thebrakshow/VORON/PCB/XY Endstop/README.md

XY Endstop

# MZBOT XY Endstop
Hall effect endstop board for X and Y axes

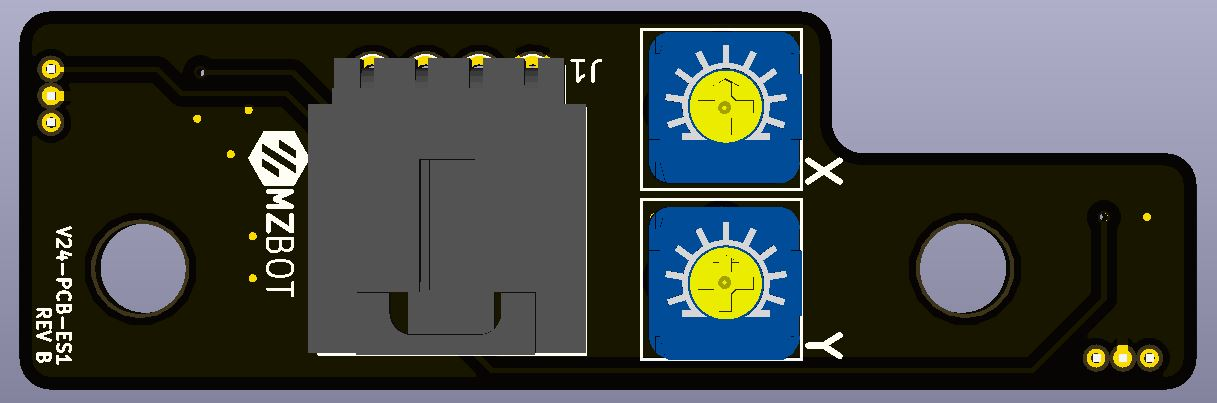
[picture p1: PCB/XY Endstop/XY_Endstop_Top.JPG]

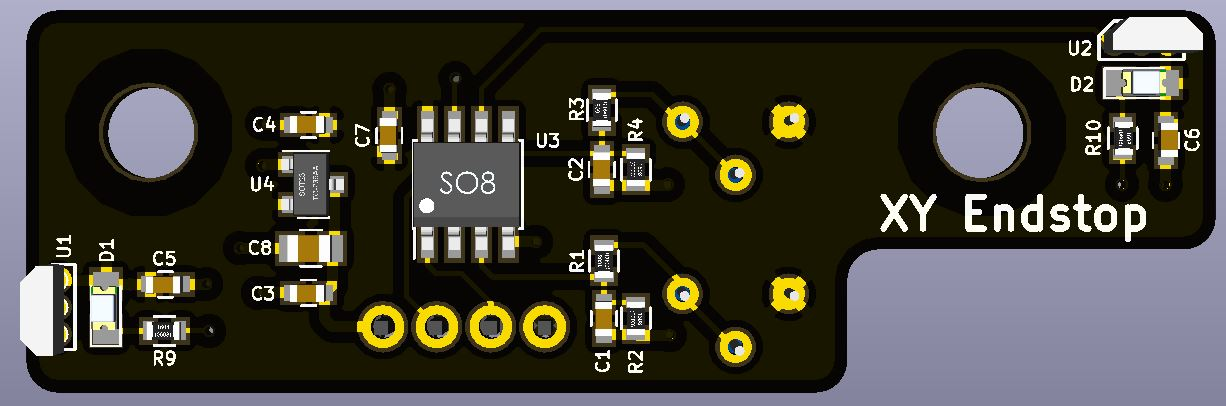
[picture p2: PCB/XY Endstop/XY_Endstop_Back.JPG]
