thebrakshow/VORON/PCB/RAMPS Expansion/README.md

# VORON V2-Expander
Expansion PCB to add 3 additional stepper drivers, 2 external PWM fans, and induction probe port to a standard RAMPS 1.4 shield

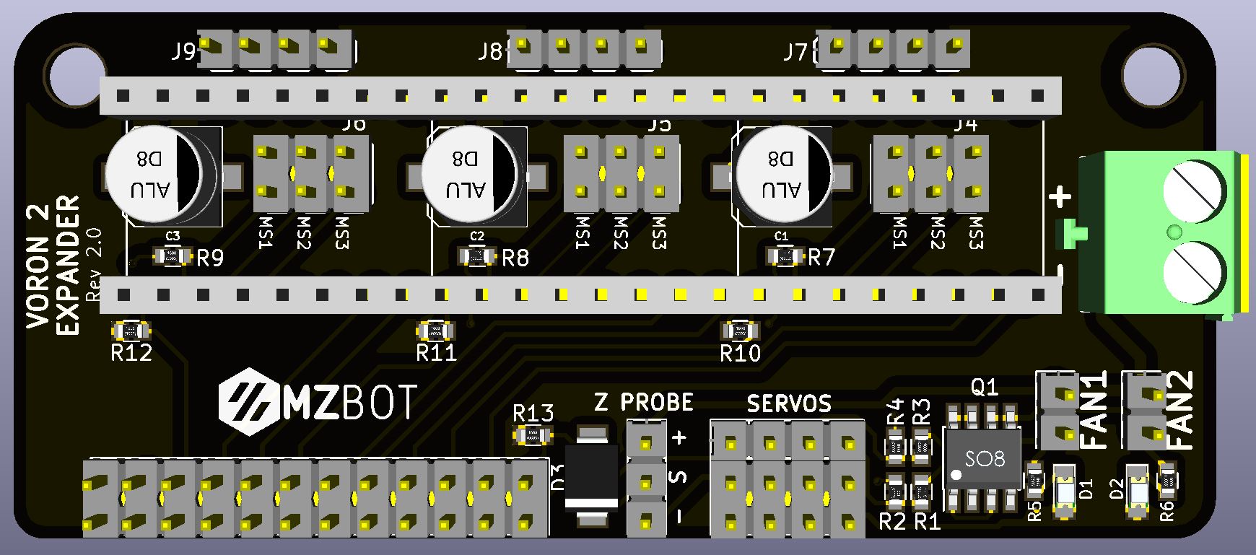
[picture p3: PCB/RAMPS Expansion/VORON_V2.0_Expander.JPG]
Optional Title
