thebrakshow/VORON/PCB/RAMPS Expansion Bridge/README.md

# VORON V2-Expansion Bridge
Expansion PCB to bridge the VORON Expander and a RAMPS 1.4 

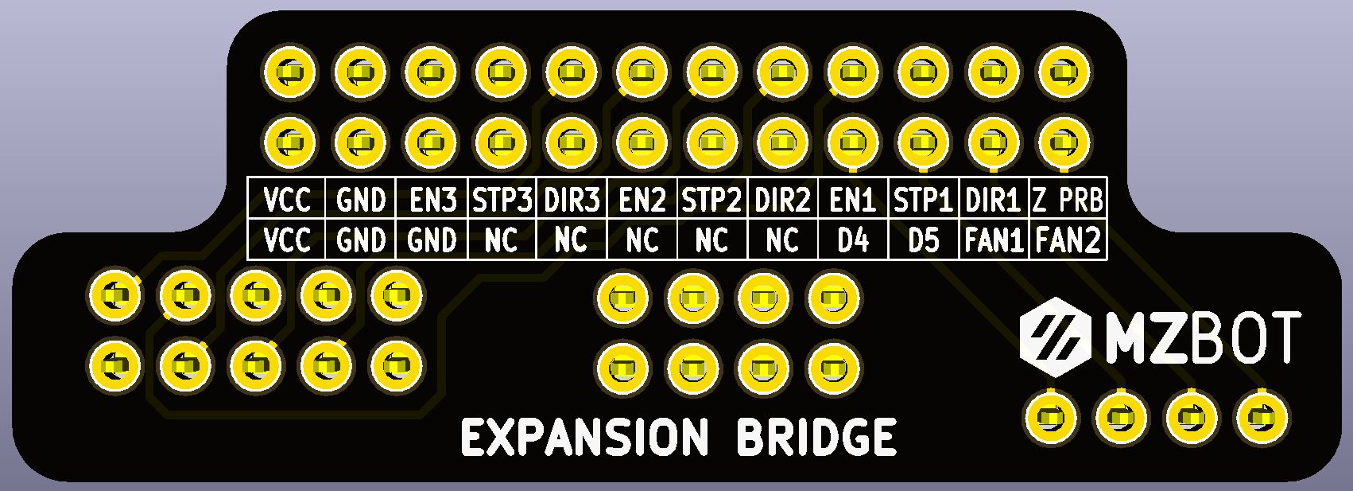
[picture p4: PCB/RAMPS Expansion Bridge/VORON_Expansion_Bridge.JPG]
Optional Title
