thebrakshow/VORON/PCB/RAMPS Expansion Bridge/Expander_Bridge_BOM.xlsx

Title | Expander Bridge
Company | MZBOT
Revision | A
Date Issue | 2017-01-04 22:13
Quantity | Reference | Description | Manufacture | Manufacture P/N | Digi-Key | Price @ 1 | Price @ 100
1 | J1 | CONN HEADER FEMALE 4 POS 2.54 | Sullins Connector Solutions | PPTC041LFBN-RC | S7002-ND | $0.45 | $0.3250
4 | J2 | CONN HEADER FEMALE 8 POS 2.54 | Sullins Connector Solutions | PPTC042LFBN-RC | S7072-ND | $0.67 | $0.5069
3 | J3 | CONN HEADER FEMALE 10 POS 2.54 | Sullins Connector Solutions | PPTC052LFBN-RC | S6105-ND | $0.69 | $0.5207
2 | J4 | CONN HEADER FEMALE 24 POS 2.54 | Sullins Connector Solutions | PPTC122LFBN-RC | S7080-ND | $1.46 | $1.1340
1 |  | PCB | MZBOT |  | - | $0.49 | $0.2732
