thebrakshow/VORON/PCB/RAMPS Expansion/VORON_V2.0_EXPANDER_BOM.xlsx

Title | VORON V2.0 Expander
Company | MZBOT
Revision | B
Date Issue | 2017-01-04 22:13
Quantity | Reference | Description | Manufacture | Manufacture P/N | Digi-Key | Price @ 1 | Price @ 100
1 | P1 | CONN HEADER 24POS 2.54 STR 15AU | Amphenol FCI | 67997-224HLF | 609-3395-ND | $0.91 | $0.6923
4 | P2, J7, J8, J9 | CONN HEADER 4 POS 2.54 | Wurth Electronics Inc. | 61300411121 | 732-5317-ND | $0.18 | $0.0960
3 | J4, J5, J6 | CONN HEADER 6 POS 2.54 | Harwin Inc. | M20-9980346 | 952-2121-ND | $0.24 | $0.1586
2 | FAN1, FAN2 | CONN HEADER 2 POS 2.54 | Harwin Inc. | M20-9990246 | 952-2262-ND | $0.11 | $0.0609
1 | P3 | CONN HEADER 3 POS 2.54 | Wurth Electronics Inc. | 61300311121 | 732-5316-ND | $0.15 | $0.0670
1 | P4 | CONN HEADER 8 POS 2.54 | Harwin Inc. | M20-9980446 | 952-2123-ND | $0.30 | $0.1960
1 | PWRIN1 | TERM BLOCK 2POS 5.08MM PCB HORIZ | Amphenol Anytek | VI0221520000G | 609-3936-ND | $0.88 | $0.4113
3 | C1, C2, C3 | CAP ALUM 100UF 20% 35V SMD | Nichicon | UWT1V101MCL1GS | 493-2203-1-ND | $0.39 | $0.1641
2 | R1, R3, | RES SMD 100 OHM 1% 1/10W 0603 | Yageo | RC0603FR-07100RL | 311-100HRCT-ND | $0.10 | $0.0060
5 | R2, R4, R7, R8, R9 | RES SMD 100K OHM 1% 1/10W 0603 | Yageo | RC0603FR-07100KL | 311-100KHRCT-ND | $0.10 | $0.0060
2 | R5, R6, | RES SMD 1.8K OHM 1% 1/10W 0603 | Yageo | RC0603FR-071K8L | 311-1.80KHRCT-ND | $0.10 | $0.0060
4 | R10, R11, R12, R13 | RES SMD 10K OHM 1% 1/10W 0603 | Yageo | RCRC0603FR-0710KL | 311-10.0KHRCT-ND | $0.10 | $0.0060
1 | Q1 | MOSFET 2N-CH 30V 9.7A 8-SOIC | Infineon Technologies | IRF8313TRPBF | IRF8313TRPBFCT-ND | $0.77 | $0.5180
6 | Stepstick1, Stepstick2, Stepstick3, (x2 each) | CONN HEADER FEMALE 8 POS 2.54 | Sullins Connector Solutions | PPTC081LFBN-RC | S7006-ND | $0.65 | $0.4658
2 | D1, D2 | LED RED DIFFUSED 0805 SMD | OSRAM Opto Semiconductors Inc. | LS R976-NR-1 | 475-1278-1-ND | $0.26 | $0.0998
1 | D3 | DIODE SCHOTTKY 60V 1A SMA | Diodes Incorporated | B160-13-F | B160-FDICT-ND | $0.37 | $0.1615
9 |  | CONN JUMPER SHORTING TIN | Sullins Connector Solutions | STC02SYAN | S9000-ND | $0.10 | $0.0365
1 |  | PCB | MZBOT |  | - | $0.49 | $0.2732
