thebrakshow/VORON/PCB/XY Endstop/MZBOT_XY-Endstop_BOM.xlsx

Title | XY-Endstop
Company | MZBOT
Revision | B
Date Issue | 2017-01-04 22:13
Quantity | Reference | Description | Manufacture | Manufacture P/N | Digi-Key | Price @ 1 | Price @ 100
1 | J1 | CONN HEADER 3POS .100 R/A GOLD | Molex | 705530002 | WM4901-ND | $1.06 | $0.8100
2 | R2, R4 | RES SMD 10K OHM 1% 1/10W 0603 | Yageo | RC0603FR-0710KL | 311-10.0KHRCT-ND | $0.10 | $0.0060
2 | C1, C2 | CAP CER 0.1UF 16V X7R 0603 | Yageo | CC0603KRX7R7BB104 | 311-1088-1-ND | $0.10 | $0.0095
4 | R1, R3, R9, R10 | RES SMD 1K OHM 1% 1/10W 0603 | Yageo | RC0603FR-071KL | 311-1.00KHRCT-ND | $0.10 | $0.0060
2 | VR1, VR2 | TRIMMER 10K OHM 0.25W SMD | Nidec Copal Electronics | CT6EP103 | CT6EP103-ND | $0.79 | $0.5852
1 | U3 | IC COMPARATOR DUAL DIFF 8-SOP | ON Semiconductor | LM393M | LM393MFS-ND | $0.35 | $0.1949
1 | U4 | IC REG LINEAR 3.3V 300MA SOT23-3 | Diodes Incorporated | AP2210N-3.3TRG1 | AP2210N-3.3TRG1DICT-ND | $0.42 | $0.1973
1 | C8 | CAP CER 10UF 16V X5R 0805 | Samsung Electro-Mechanics | CL21A106KOQNNNG | 1276-6455-1-ND | $0.13 | $0.0444
2 | U1, U2 | SENSOR LINEAR ANALOG RADIAL | Honeywell Sensing and Productivity Solutions | SS49E | 480-2006-ND | $2.37 | $1.1757
2 | D1, D2 | LED RED DIFFUSED 0805 SMD | OSRAM Opto Semiconductors Inc. | LS R976-NR-1 | 475-1278-1-ND | $0.26 | $0.0998
5 | C3, C4, C5, C6, C7 | CAP CER 1UF 16V X7R 0603 | Taiyo Yuden | EMK107B7105KA-T | 587-1241-1-ND | $0.10 | $0.0310
1 | PCB1 | PCB | MZBOT | V24-PCB-ES1 | - | $0.49 | $0.2732
