thebrakshow/VORON/PCB/RAMPS Expansion Bridge/VORON_V2.0_Expansion_Bridge.step

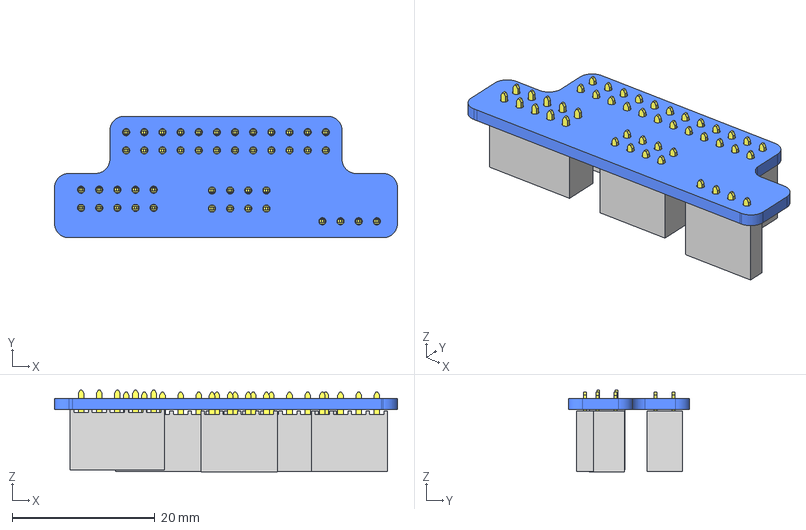
[picture p5: CAD file, 2017-12-31]
PCB/RAMPS Expansion Bridge/VORON_V2.0_Expansion_Bridge.step
48.0 x 17.0 x 11.5 mm
Pcb
PIN_SOCKET_BOTTON_2X5_
PIN_SOCKET_BOTTON_2X4_
PIN_SOCKET_BOTTON_1X4_
PIN_SOCKET_BOTTOM_2X12_
