thebrakshow/VORON/PCB/RAMPS Expansion/VORON_V2.0_Expander.pdf

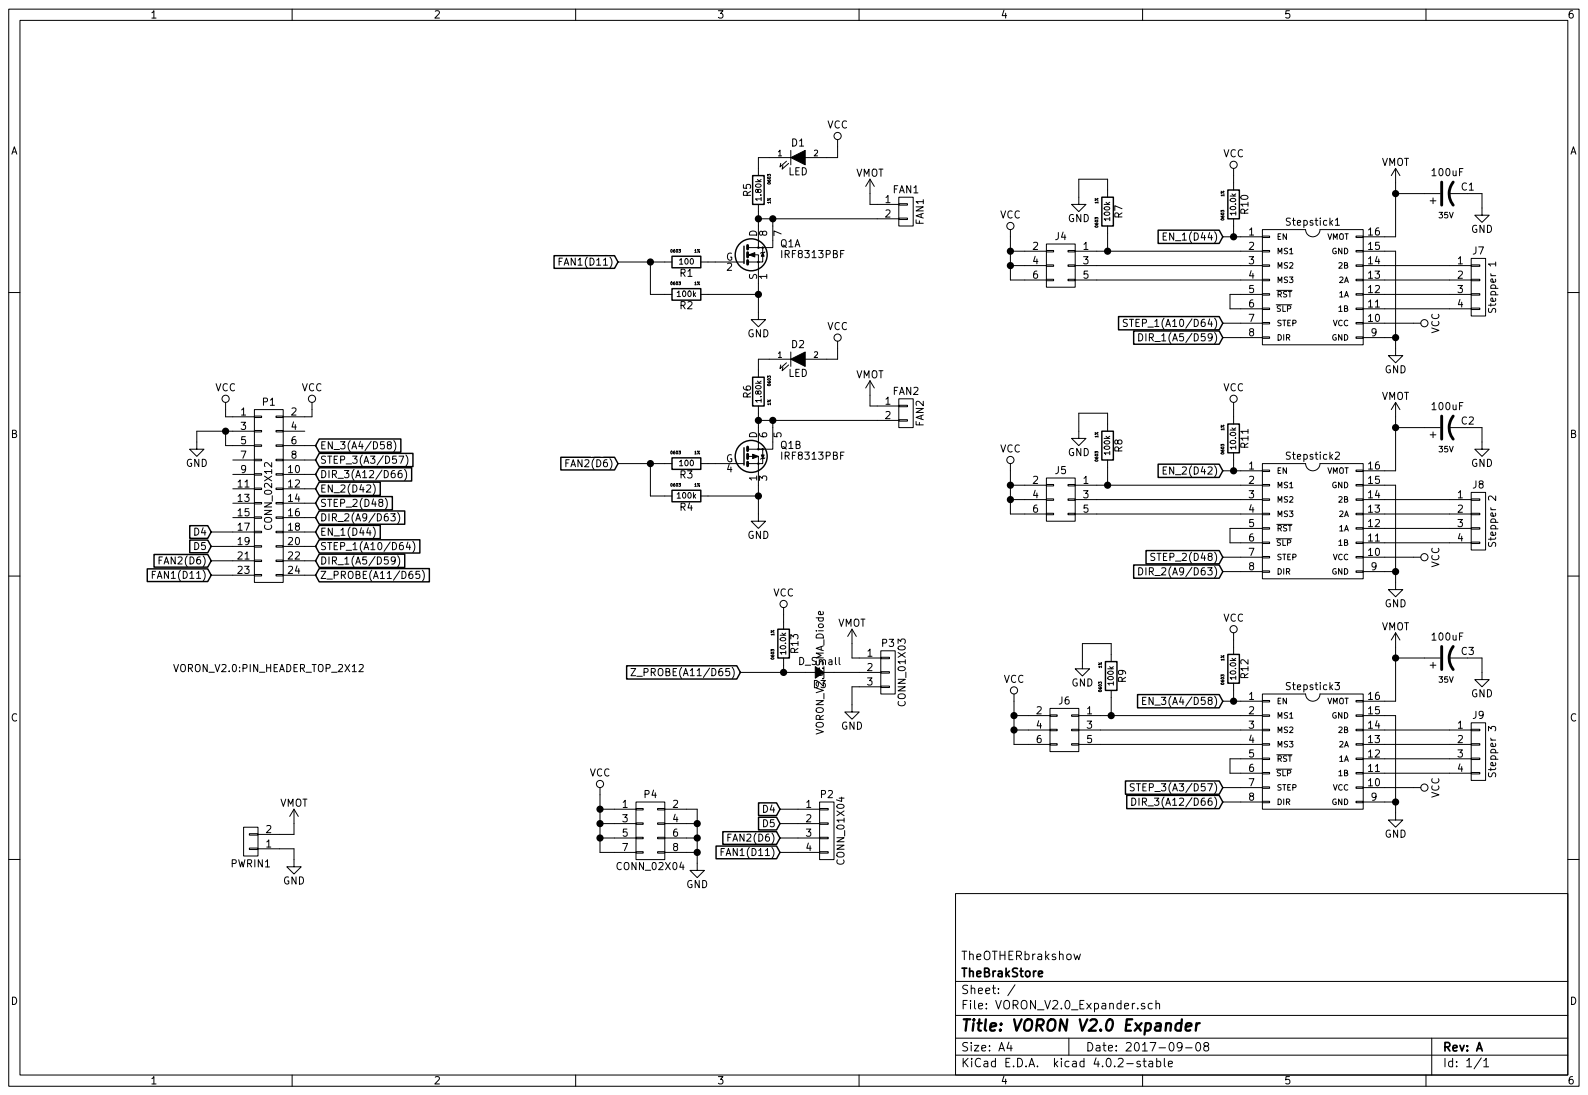
[picture p6: page 1]

12 | 1A
11 | 1B

13 | 2A

File: VORON_V2.0_Expander.sch Sheet: / TheBrakStore TheOTHERbrakshow

Id: 1/1 Title: VORON V2.0 Expander
