thebrakshow/VORON/PCB/RAMPS Expansion Bridge/VORON_V2.0_Expansion_Bridge.pdf

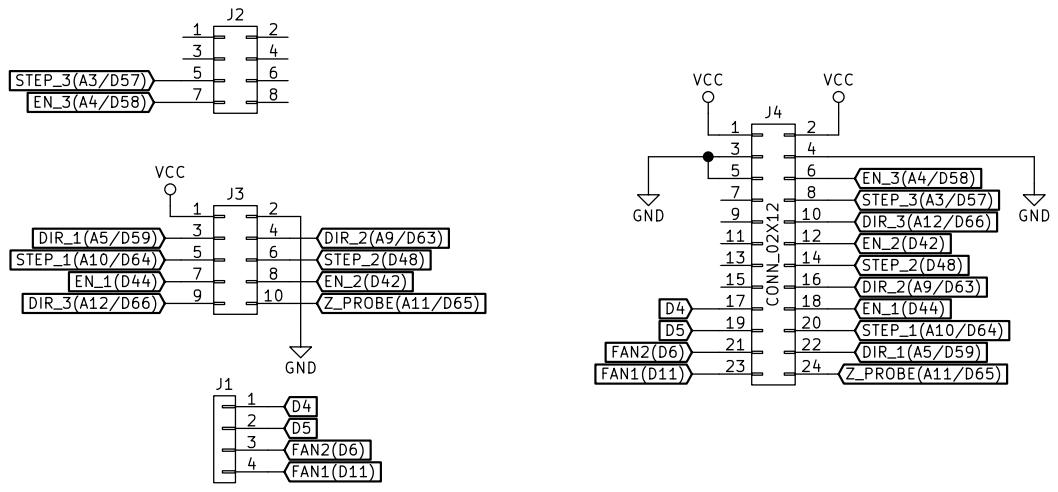
[picture p7: page 1]

Id: 1/1 Title: VORON Expansion Bridge
