thebrakshow/VORON/PCB/XY Endstop/KiCad/MZBOT_XY-Endstop.kicad_pcb

## KiCad design PCB/XY Endstop/KiCad/MZBOT_XY-Endstop.kicad_pcb (2018-01-05)

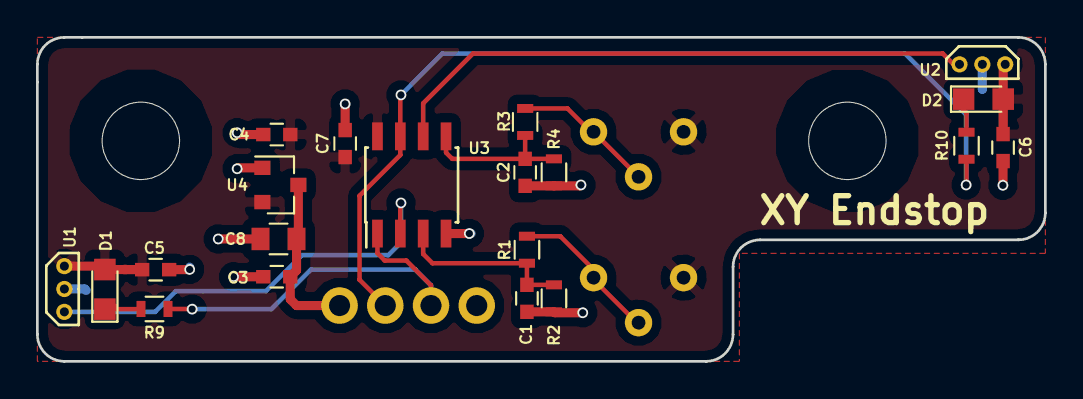
[picture p8: board MZBOT_XY-Endstop.kicad_pcb from above]

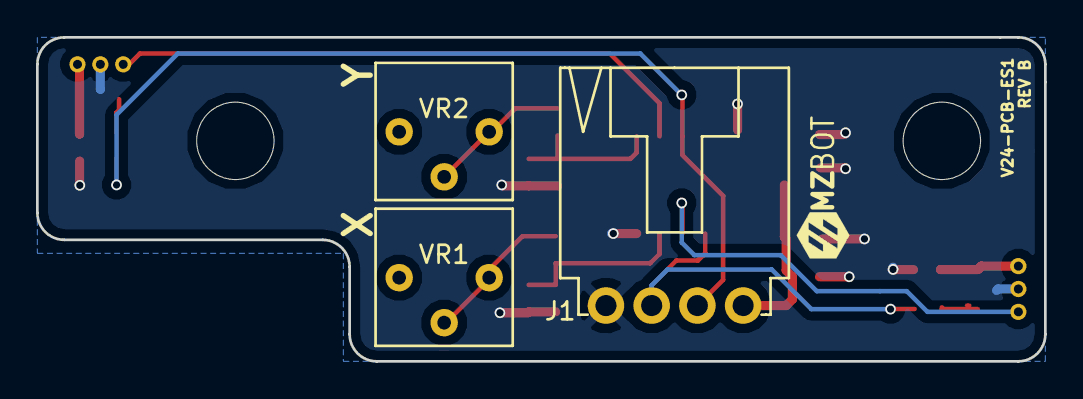
[picture p9: board MZBOT_XY-Endstop.kicad_pcb from below]

Board: 2 copper layers, 56.0 x 18.0 mm, 23 parts (3 on the bottom side), 13 nets.

Parts:
C1, C2: 0.1uF; C_0603
C3, C4, C5, C6, C7: 1uF; C_0603
C8: 10uF; C_0805
D1, D2: LED_0805
J1: CONN_01X04; 1X4_CONN_L_RA
R1, R3, R9, R10: 1.00K; R_0603
R2, R4: 10.0k; R_0603
U1, U2: SS49E; SIP-3
U3: LM393; SOIC-8_3.9x4.9mm_Pitch1.27mm
U4: AP2210N; SOT-23
VR1, VR2: 10.0K; CT6EP103

Connections:
+3V3: C4.1, C5.1, C6.1, C7.2, D1.2, D2.2, U1.1, U2.1, U3.8, U4.2, VR1.3, VR2.3
+5V: C3.1, C8.1, J1.4, U4.3
GND: C1.2, C2.2, C3.2, C4.2, C5.2, C6.2, C7.1, C8.2, J1.1, R2.2, R4.2, U1.2, U2.2, U3.4, U4.1
unnamed: C1.1, R1.1, R2.1, U3.3
unnamed: C2.1, R3.1, R4.1, U3.5
unnamed: D1.1, R9.1
unnamed: D2.1, R10.1
unnamed: R1.2, VR1.1, VR1.2
unnamed: R3.2, VR2.1, VR2.2
unnamed: U1.3, U3.2
unnamed: U2.3, U3.6
X_SIG: J1.2, R9.2, U3.1
Y_SIG: J1.3, R10.2, U3.7
