thebrakshow/VORON/PCB/RAMPS Expansion/KiCad/VORON_V2.0_Expander.kicad_pcb

## KiCad design PCB/RAMPS Expansion/KiCad/VORON_V2.0_Expander.kicad_pcb (2017-12-31)

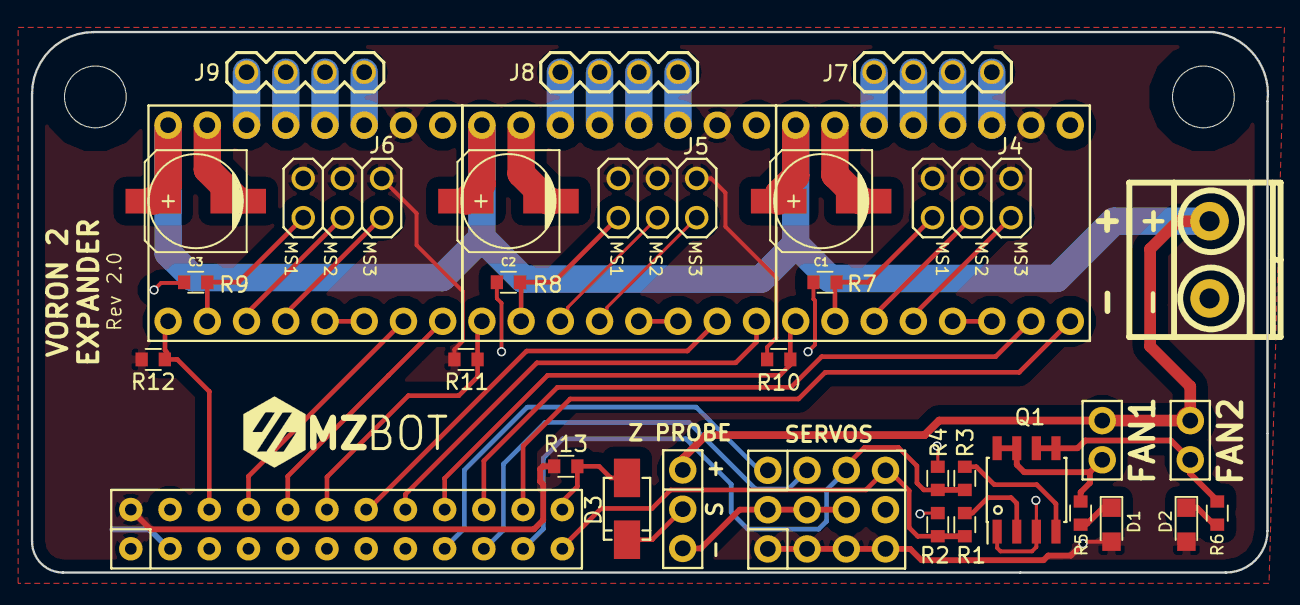
[picture p10: board VORON_V2.0_Expander.kicad_pcb from above]

Board: 2 copper layers, 80.0 x 35.0 mm, 36 parts (0 on the bottom side), 48 nets.

Parts:
C1, C2, C3: 100uF; c_elec_6.3x7.7
D1, D2: LED; LED_0805
D3: D_Small; SMA_Diode
FAN1: FAN1; PIN_HEADER_TOP_1X2
FAN2: FAN2; PIN_HEADER_TOP_1X2
J4, J5, J6: CONN_02X03; 2X03_PIN_HEADER
J7: Stepper 1; 1X04_PIN_HEADER
J8: Stepper 2; 1X04_PIN_HEADER
J9: Stepper 3; 1X04_PIN_HEADER
P1: CONN_02X12; PIN_HEADER_TOP_2X12
P2: CONN_01X04; PIN_HEADER_TOP_1X4
P3: CONN_01X03; PIN_HEADER_TOP_1X3
P4: CONN_02X04; PIN_HEADER_TOP_2x4
PWRIN1: PWRIN; mkds_1,5-2
Q1: IRF8313PBF; SOIC-8_3.9x4.9mm_Pitch1.27mm
R1, R3: 100; R_0603
R2, R4, R7, R8, R9: 100k; R_0603
R5, R6: 1.80k; R_0603
R10, R11, R12, R13: 10.0k; R_0603
Stepstick1, Stepstick2, Stepstick3: Stepstick; Steppers

Connections:
D4: P1.17, P2.1
D5: P1.19, P2.2
DIR_1(A5/D59): P1.22, Stepstick1.8
DIR_2(A9/D63): P1.16, Stepstick2.8
DIR_3(A12/D66): P1.10, Stepstick3.8
EN_1(D44): P1.18, R10.2, Stepstick1.1
EN_2(D42): P1.12, R11.2, Stepstick2.1
EN_3(A4/D58): P1.6, R12.2, Stepstick3.1
FAN1(D11): P1.23, P2.4, R1.2, R2.2
FAN2(D6): P1.21, P2.3, R3.2, R4.2
GND: C1.2, C2.2, C3.2, P1.3, P1.5, P3.3, P4.2, P4.4, P4.6, P4.8, PWRIN1.1, Q1.1, Q1.3, R2.1, R4.1, R7.1, R8.1, R9.1, Stepstick1.9, Stepstick1.15, Stepstick2.9, Stepstick2.15, Stepstick3.9, Stepstick3.15
unnamed: D1.1, R5.2
unnamed: D2.1, R6.2
unnamed: D3.1, P3.2
unnamed: FAN1.2, Q1.7, Q1.8, R5.1
unnamed: FAN2.2, Q1.5, Q1.6, R6.1
unnamed: J4.1, R7.2, Stepstick1.2
unnamed: J4.3, Stepstick1.3
unnamed: J4.5, Stepstick1.4
unnamed: J5.1, R8.2, Stepstick2.2
unnamed: J5.3, Stepstick2.3
unnamed: J5.5, Stepstick2.4
unnamed: J6.1, R9.2, Stepstick3.2
unnamed: J6.3, Stepstick3.3
unnamed: J6.5, Stepstick3.4
unnamed: J7.1, Stepstick1.14
unnamed: J7.2, Stepstick1.13
unnamed: J7.3, Stepstick1.12
unnamed: J7.4, Stepstick1.11
unnamed: J8.1, Stepstick2.14
unnamed: J8.2, Stepstick2.13
unnamed: J8.3, Stepstick2.12
unnamed: J8.4, Stepstick2.11
unnamed: J9.1, Stepstick3.14
unnamed: J9.2, Stepstick3.13
unnamed: J9.3, Stepstick3.12
unnamed: J9.4, Stepstick3.11
unnamed: Q1.2, R1.1
unnamed: Q1.4, R3.1
unnamed: Stepstick1.5, Stepstick1.6
unnamed: Stepstick2.5, Stepstick2.6
unnamed: Stepstick3.5, Stepstick3.6
STEP_1(A10/D64): P1.20, Stepstick1.7
STEP_2(D48): P1.14, Stepstick2.7
STEP_3(A3/D57): P1.8, Stepstick3.7
VCC: D1.2, D2.2, J4.2, J4.4, J4.6, J5.2, J5.4, J5.6, J6.2, J6.4, J6.6, P1.1, P1.2, P4.1, P4.3, P4.5, P4.7, R10.1, R11.1, R12.1, R13.1, Stepstick1.10, Stepstick2.10, Stepstick3.10
VMOT: C1.1, C2.1, C3.1, FAN1.1, FAN2.1, P3.1, PWRIN1.2, Stepstick1.16, Stepstick2.16, Stepstick3.16
Z_PROBE(A11/D65): D3.2, P1.24, R13.2
