thebrakshow/VORON/PCB/RAMPS Expansion Bridge/KiCad/VORON_V2.0_Expansion_Bridge.kicad_pcb

## KiCad design PCB/RAMPS Expansion Bridge/KiCad/VORON_V2.0_Expansion_Bridge.kicad_pcb (2017-12-31)

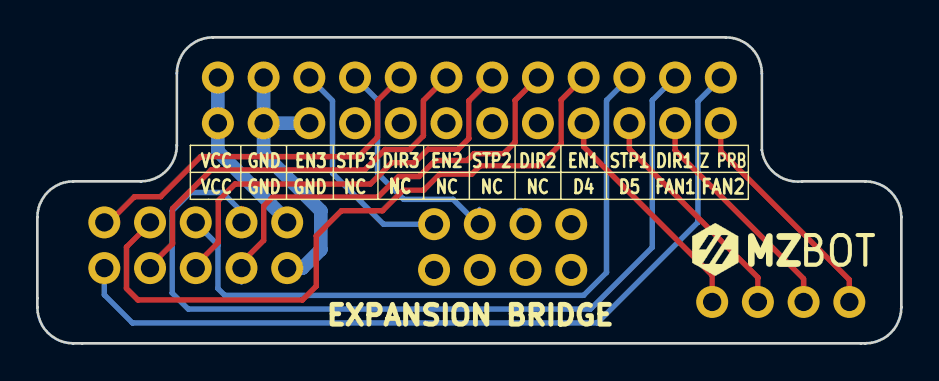
[picture p11: board VORON_V2.0_Expansion_Bridge.kicad_pcb from above]

Board: 2 copper layers, 48.0 x 17.0 mm, 4 parts (0 on the bottom side), 16 nets.

Parts:
J1: PIN_SOCKET_BOTTOM_1X4
J2: CONN_02X04; PIN_SOCKET_BOTTON_2X4
J3: CONN_02X05; PIN_SOCKET_BOTTOM_2X5
J4: CONN_02X12; PIN_SOCKET_BOTTON_2X12

Connections:
D4: J1.1, J4.17
D5: J1.2, J4.19
DIR_1(A5/D59): J3.3, J4.22
DIR_2(A9/D63): J3.4, J4.16
DIR_3(A12/D66): J3.9, J4.10
EN_1(D44): J3.7, J4.18
EN_2(D42): J3.8, J4.12
EN_3(A4/D58): J2.7, J4.6
FAN1(D11): J1.4, J4.23
FAN2(D6): J1.3, J4.21
GND: J3.2, J4.3, J4.4, J4.5
STEP_1(A10/D64): J3.5, J4.20
STEP_2(D48): J3.6, J4.14
STEP_3(A3/D57): J2.5, J4.8
VCC: J3.1, J4.1, J4.2
Z_PROBE(A11/D65): J3.10, J4.24
